Mikemcdonaldceramics1/bmx-logger/hardware/sensor_clip_19mm.stl

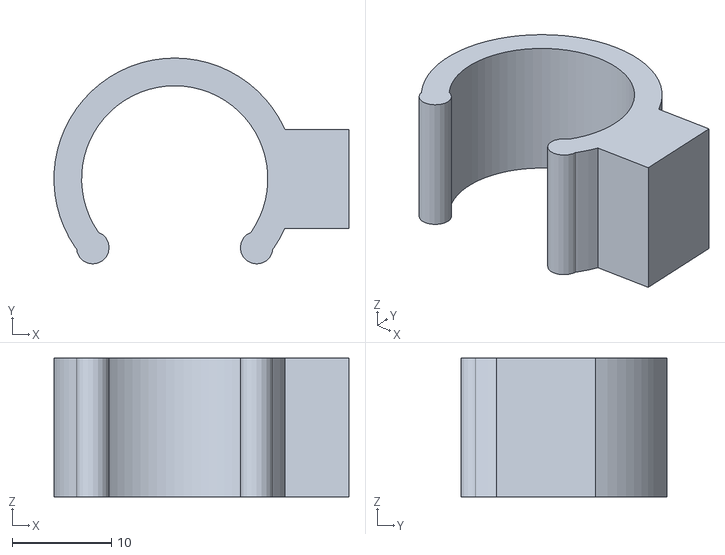
[picture p1: CAD file, 2026-11-06]
hardware/sensor_clip_19mm.stl
29.8 x 20.8 x 14.0
