Mikemcdonaldceramics1/bmx-logger/hardware/sensor_clip_22mm.stl

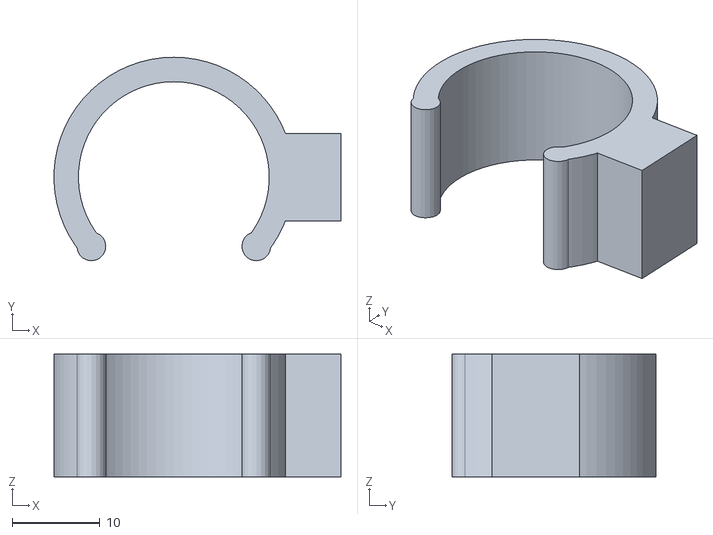
[picture p2: CAD file, 2026-11-06]
hardware/sensor_clip_22mm.stl
32.8 x 23.3 x 14.0
