Mikemcdonaldceramics1/bmx-logger/hardware/sensor_clip_16mm.stl

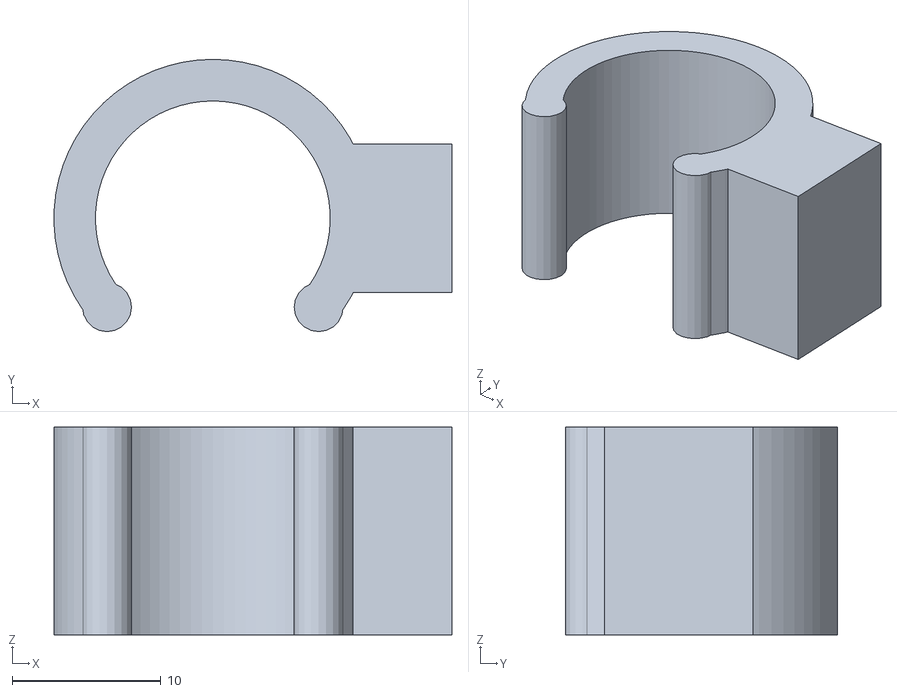
[picture p3: CAD file, 2026-11-06]
hardware/sensor_clip_16mm.stl
26.8 x 18.3 x 14.0
