Mikemcdonaldceramics1/bmx-logger/(commit log)

2026-11-05 BMX logger: firmware, phone app, Android app build
    - firmware/: ESP32 sketch (Bluetooth only) and ready-to-flash merged.bin
    - index.html: phone app (record, runs, gearing analysis)
    - android_app/: Capacitor wrapper with native Bluetooth, share-sheet saving
    - .github/workflows/build-apk.yml: builds the APK and publishes a release
    - tools/: simulated runs, analysis and Bluetooth protocol tests
    Claude-Session: https://claude.ai/code/session_01T831wPw9wJ53QzTw4CSMop
    [partitions.csv]
2026-11-06 Add printable hall sensor clip for the chainstay [skip ci]
    hardware/make_sensor_clip.py generates a snap-on C-clip with a channel for a
    heat-shrunk A3144 (1.2 mm sensing wall), as STL for 16, 19 and 22 mm stays,
    plus the 3D viewer page.
    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
    [sensor_clip_16mm.stl, sensor_clip_19mm.stl, sensor_clip_22mm.stl]
2026-11-08 Arm and wait for the gate start; Start and stop settings
    Firmware: arming now waits for the start instead of recording at once. While
    armed it keeps the last 3 s in RAM; it starts saving when the wheel reaches
    the launch speed within 4 s of rolling after standing still (launch_detect.h,
    unit tests in tools/test_launch_detect.cpp). It stops when the wheel has been
    still, or after the longest-run limit, then arms again for the next moto.
    Disarm discards the unused slot. Runs are dated at the start.
    App: ARMED status with time waiting and runs saved, Disarm button, and a
    Start and stop settings card (launch speed, stand-still time, stop delay,
    longest run, re-arm). Launch speed is stored in 0.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
2026-11-08 Show battery level in the app
    Firmware reads the battery through an optional 100k/100k divider on D35
    (averaged and smoothed), converts it to a lithium-ion percentage, and adds
    batt / battPct to the status. The app header shows "Battery NN%", amber at
    25% and red at 10%, and hides it when no divider is fitted.
    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
2026-11-08 Fix header covering the top of each page on Android; always show battery chip
    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
